cuspaceflight/white-giant-sensing-pcb/README.md

# WG-sensing-pcb
PCB Design for WGData Acquisition via Current Loop Sensors

Current Design in KiCAD for 2x12 Sensors.

## Next Steps
- Create a separate Buck Converter board for a clean 5.4V DC supply
- Rework PCB Layout to only integrate some 5 sensors and test different designs
