cuspaceflight/white-giant-sensing-pcb/daq_griffin/daq_griffin.kicad_pcb

## KiCad design daq_griffin/daq_griffin.kicad_pcb (2025-04-25)

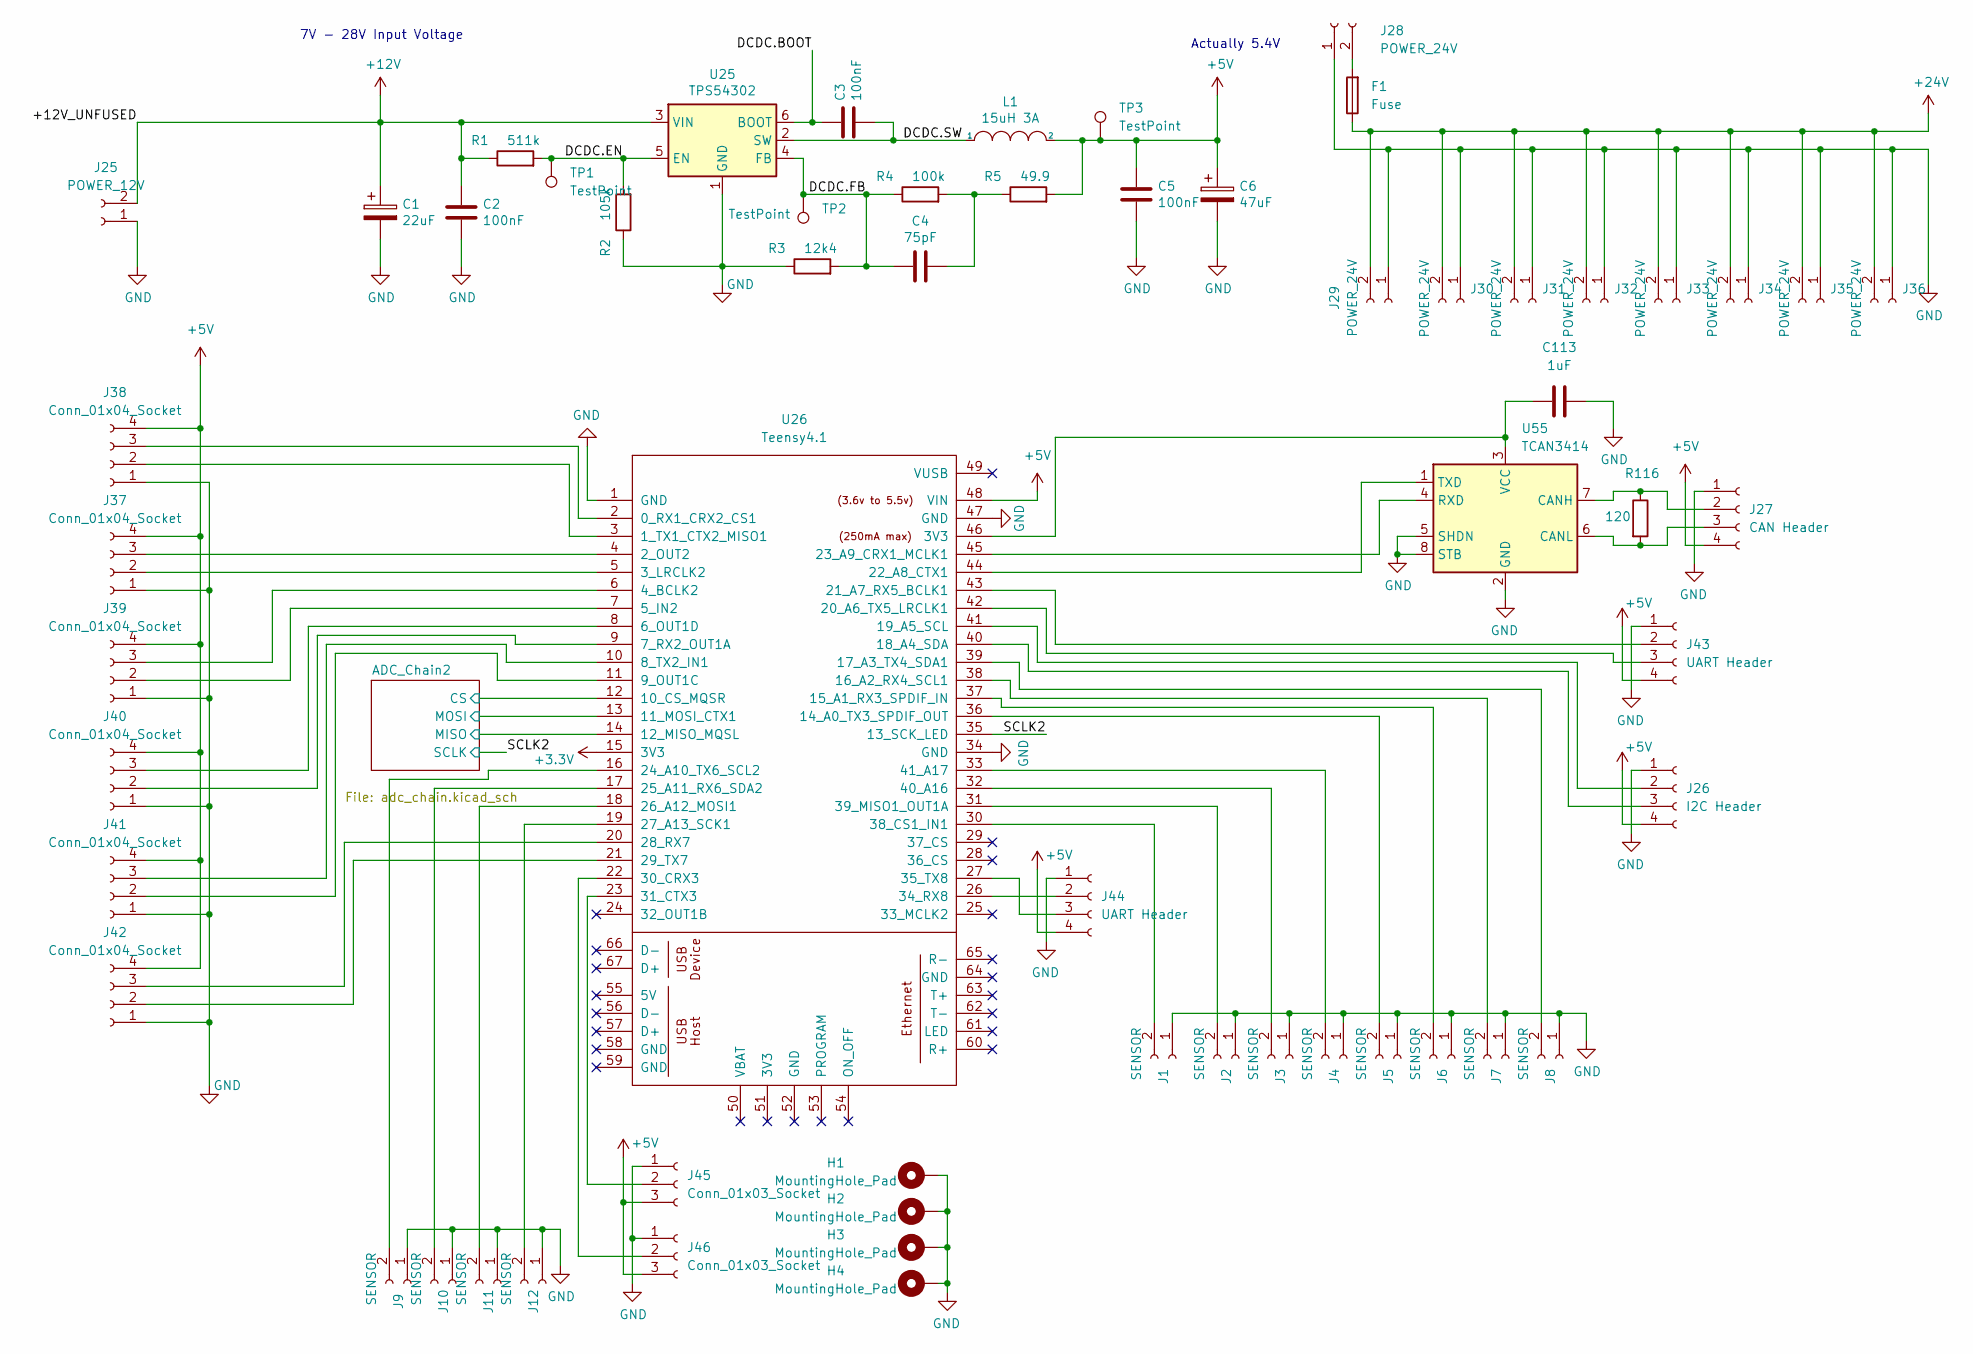
[picture p1: schematic daq_griffin.kicad_sch]

Parts:
C1: 22uF; C_0805_2012Metric_Pad1.18x1.45mm_HandSolder; Rating 25V; MPN generic C%f %v %r; LCSC C5674
C2, C3, C5: 100nF; C_0603_1608Metric_Pad1.08x0.95mm_HandSolder; MPN generic C%f %v %r; LCSC C1590
C4: 75pF; C_0603_1608Metric_Pad1.08x0.95mm_HandSolder; MPN generic C%f %v %r; LCSC C1681
C6: 47uF; C_0805_2012Metric_Pad1.18x1.45mm_HandSolder; Rating 6.3V; MPN generic C%f %v %r; LCSC C16780
C113: 1uF; C_0603_1608Metric_Pad1.08x0.95mm_HandSolder; LCSC C1592
F1: Fuse; Fuseholder_Cylinder-5x20mm_Stelvio-Kontek_PTF78_Horizontal_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
H1, H2, H3, H4: MountingHole_Pad; MountingHole_3.2mm_M3_Pad_Via
J1, J2, J3, J4, J5, J6, J7, J8, J9, J10, J11, J12: SENSOR; Molex_Nano-Fit_105309-xx02_1x02_P2.50mm_Vertical
J25: POWER_12V; Molex_Nano-Fit_105309-xx02_1x02_P2.50mm_Vertical
J26: I2C Header; Molex_Nano-Fit_105309-xx04_1x04_P2.50mm_Vertical
J27: CAN Header; Molex_Nano-Fit_105309-xx04_1x04_P2.50mm_Vertical
J28, J29, J30, J31, J32, J33, J34, J35, J36: POWER_24V; Molex_Nano-Fit_105309-xx02_1x02_P2.50mm_Vertical
J37, J38, J39, J40, J41, J42: Conn_01x04_Socket; JST_XH_B4B-XH-A_1x04_P2.50mm_Vertical
J43, J44: UART Header; Molex_Nano-Fit_105309-xx04_1x04_P2.50mm_Vertical
J45, J46: Conn_01x03_Socket; Molex_Nano-Fit_105309-xx03_1x03_P2.50mm_Vertical
L1: 15uH 3A; L_Bourns_SRN6045TA; MPN Bourns SRN8040TA-150M; LCSC C1330797
R1: 511k; R_0603_1608Metric_Pad0.98x0.95mm_HandSolder; MPN generic R%f %v %r; LCSC C188257
R2: 105k; R_0603_1608Metric_Pad0.98x0.95mm_HandSolder; MPN generic R%f %v %r; LCSC C16840
R3: 12k4; R_0603_1608Metric_Pad0.98x0.95mm_HandSolder; MPN generic R%f %v %r; LCSC C22865
R4: 100k; R_0603_1608Metric_Pad0.98x0.95mm_HandSolder; MPN generic R%f %v %r; LCSC C14675
R5: 49.9; R_0603_1608Metric_Pad0.98x0.95mm_HandSolder; MPN generic R%f %v %r; LCSC C23185
R116: 120; R_0603_1608Metric_Pad0.98x0.95mm_HandSolder; LCSC C22787
TP1, TP2, TP3: TestPoint; TestPoint_Pad_D1.0mm
U25: TPS54302; SOT-23-6; MPN TI TPS54302DDC; LCSC C129370
U26: Teensy4.1; Teensy41
U55: TCAN3414; SOIC-8_3.9x4.9mm_P1.27mm; LCSC C30111221

Connections:
+3.3V: U26.15 (3V3); also elsewhere on the board
+5V: C5.1, C6.1, J26.4, J27.4, J37.4, J38.4, J39.4, J40.4, J41.4, J42.4, J43.4, J44.4, J45.3, J46.3, L1.2, R5.2, TP3.1, U26.48 (VIN); also elsewhere on the board
+12V: C1.1, C2.1, J25.2, R1.1, U25.3 (VIN); also elsewhere on the board
+24V: F1.1, J29.2, J30.2, J31.2, J32.2, J33.2, J34.2, J35.2, J36.2
/ADC_Chain2/CS: U26.12 (10_CS_MQSR); also elsewhere on the board
/ADC_Chain2/MISO: U26.14 (12_MISO_MQSL); also elsewhere on the board
/ADC_Chain2/MOSI: U26.13 (11_MOSI_CTX1); also elsewhere on the board
/DCDC.BOOT: C3.1, U25.6 (BOOT)
/DCDC.EN: R1.2, R2.2, TP1.1, U25.5 (EN)
/DCDC.FB: C4.2, R3.2, R4.1, TP2.1, U25.4 (FB)
/DCDC.SW: C3.2, L1.1, U25.2 (SW)
/SCLK2: U26.35 (13_SCK_LED); also elsewhere on the board
GND: C1.2, C2.2, C5.2, C6.2, C113.2, H1.1, H2.1, H3.1, H4.1, J1.1, J2.1, J3.1, J4.1, J5.1, J6.1, J7.1, J8.1, J9.1, J10.1, J11.1, J12.1, J25.1, J26.1, J27.1, J28.1, J29.1, J30.1, J31.1, J32.1, J33.1, J34.1, J35.1, J36.1, J37.1, J38.1, J39.1, J40.1, J41.1, J42.1, J43.1, J44.1, J45.1, J46.1, R2.1, R3.1, U25.1 (GND), U26.1 (GND), U26.34 (GND), U26.47 (GND), U55.2 (GND), U55.5 (SHDN), U55.8 (STB); also elsewhere on the board
unnamed: C4.1, R4.2, R5.1
unnamed: J1.2, U26.30 (38_CS1_IN1)
unnamed: J2.2, U26.31 (39_MISO1_OUT1A)
unnamed: J3.2, U26.32 (40_A16)
unnamed: J4.2, U26.33 (41_A17)
unnamed: J5.2, U26.36 (14_A0_TX3_SPDIF_OUT)
unnamed: J6.2, U26.37 (15_A1_RX3_SPDIF_IN)
unnamed: J7.2, U26.38 (16_A2_RX4_SCL1)
unnamed: J8.2, U26.39 (17_A3_TX4_SDA1)
unnamed: J9.2, U26.16 (24_A10_TX6_SCL2)
unnamed: J10.2, U26.17 (25_A11_RX6_SDA2)
unnamed: J11.2, U26.18 (26_A12_MOSI1)
unnamed: J12.2, U26.19 (27_A13_SCK1)
unnamed: J26.2, U26.41 (19_A5_SCL)
unnamed: J26.3, U26.40 (18_A4_SDA)
unnamed: J27.2, R116.1, U55.7 (CANH)
unnamed: J27.3, R116.2, U55.6 (CANL)
unnamed: F1.2, J28.2
unnamed: J37.2, U26.5 (3_LRCLK2)
unnamed: J37.3, U26.4 (2_OUT2)
unnamed: J38.2, U26.3 (1_TX1_CTX2_MISO1)
unnamed: J38.3, U26.2 (0_RX1_CRX2_CS1)
unnamed: J39.2, U26.7 (5_IN2)
unnamed: J39.3, U26.6 (4_BCLK2)
unnamed: J40.2, U26.9 (7_RX2_OUT1A)
unnamed: J40.3, U26.8 (6_OUT1D)
unnamed: J41.2, U26.11 (9_OUT1C)
unnamed: J41.3, U26.10 (8_TX2_IN1)
unnamed: J42.2, U26.21 (29_TX7)
unnamed: J42.3, U26.20 (28_RX7)
unnamed: J43.2, U26.43 (21_A7_RX5_BCLK1)
unnamed: J43.3, U26.42 (20_A6_TX5_LRCLK1)
unnamed: J44.2, U26.26 (34_RX8)
unnamed: J44.3, U26.27 (35_TX8)
unnamed: J45.2, U26.23 (31_CTX3)
unnamed: J46.2, U26.22 (30_CRX3)
unnamed: U26.44 (22_A8_CTX1), U55.1 (TXD)
unnamed: U26.45 (23_A9_CRX1_MCLK1), U55.4 (RXD)
unnamed: C113.1, U26.46 (3V3), U55.3 (VCC)

Notes on the sheet:
Actually 5.4V
7V - 28V Input Voltage

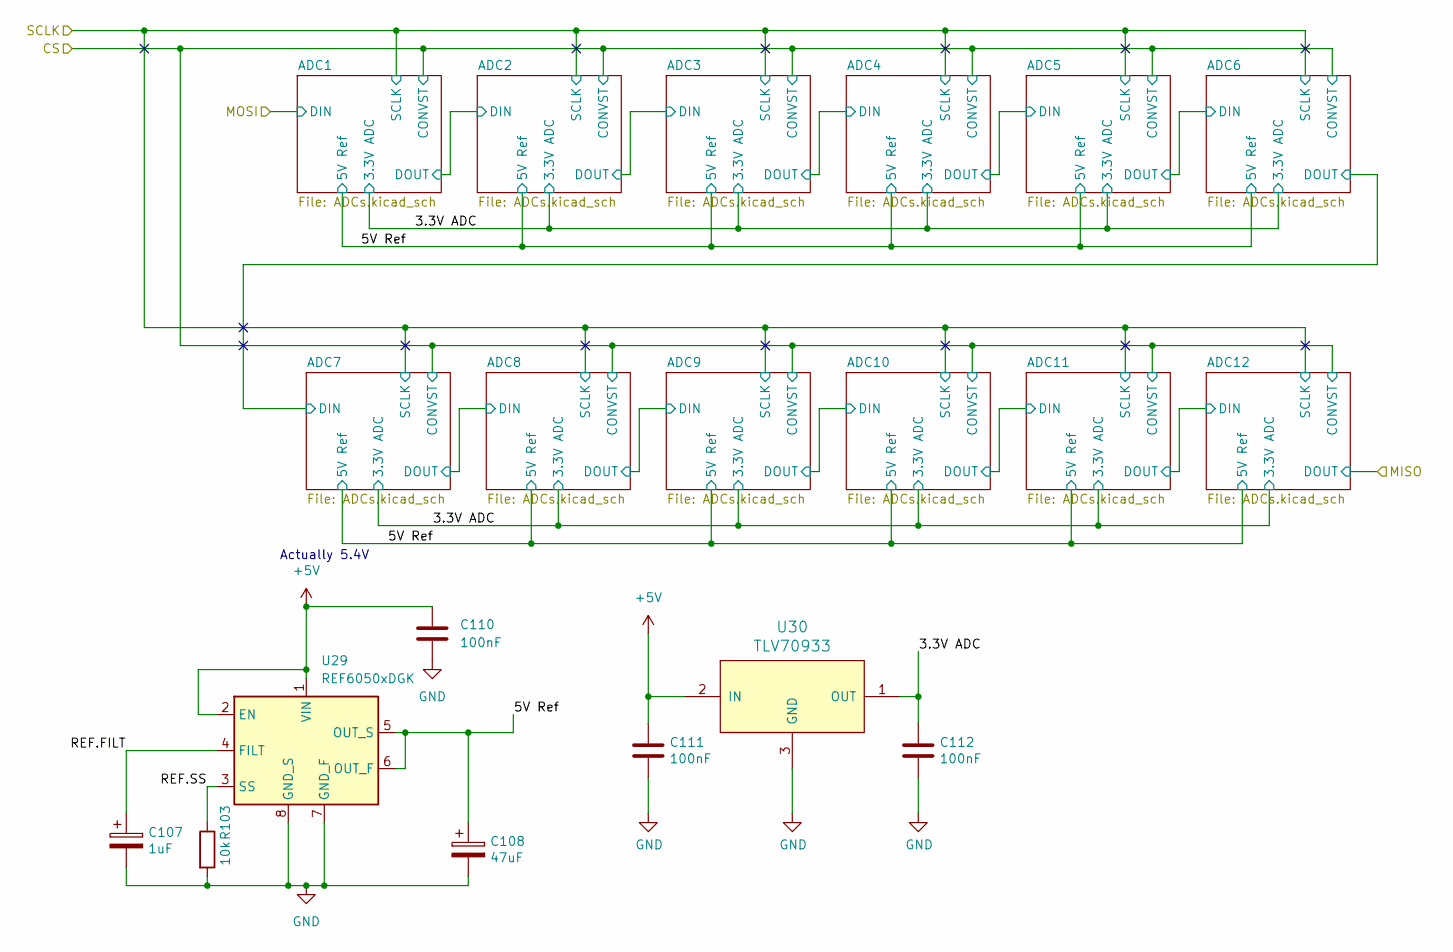
[picture p2: schematic adc_chain.kicad_sch]

Parts:
C107: 1uF; C_0603_1608Metric_Pad1.08x0.95mm_HandSolder; Rating 25V; MPN generic C%f %v %r; LCSC C1592
C108: 47uF; C_0805_2012Metric_Pad1.18x1.45mm_HandSolder; Rating 6.3V; MPN generic C%f %v %r; LCSC C16780
C110: 100nF; C_0603_1608Metric_Pad1.08x0.95mm_HandSolder; LCSC C1590
C111, C112: 100nF; C_0603_1608Metric_Pad1.08x0.95mm_HandSolder; MPN generic C%f %v %r; LCSC C1590
R103: 10k; R_0603_1608Metric_Pad0.98x0.95mm_HandSolder; MPN generic R%f %v %r; LCSC C15401
U29: REF6050xDGK; VSSOP-8_3.0x3.0mm_P0.65mm; LCSC C2157003
U30: TLV70933; SOT-23; MPN TI TLV76033DBZ; LCSC C133791

Connections:
+5V: C110.2, C111.1, U29.1 (VIN), U29.2 (EN), U30.2 (IN); also elsewhere on the board
/ADC_Chain2/3.3V ADC: C112.1, U30.1 (OUT); also elsewhere on the board
/ADC_Chain2/5V Ref: C108.1, U29.5 (OUT_S), U29.6 (OUT_F); also elsewhere on the board
/ADC_Chain2/REF.FILT: C107.1, U29.4 (FILT)
/ADC_Chain2/REF.SS: R103.1, U29.3 (SS)
GND: C107.2, C108.2, C110.1, C111.2, C112.2, R103.2, U29.7 (GND_F), U29.8 (GND_S), U30.3 (GND); also elsewhere on the board

Notes on the sheet:
Actually 5.4V

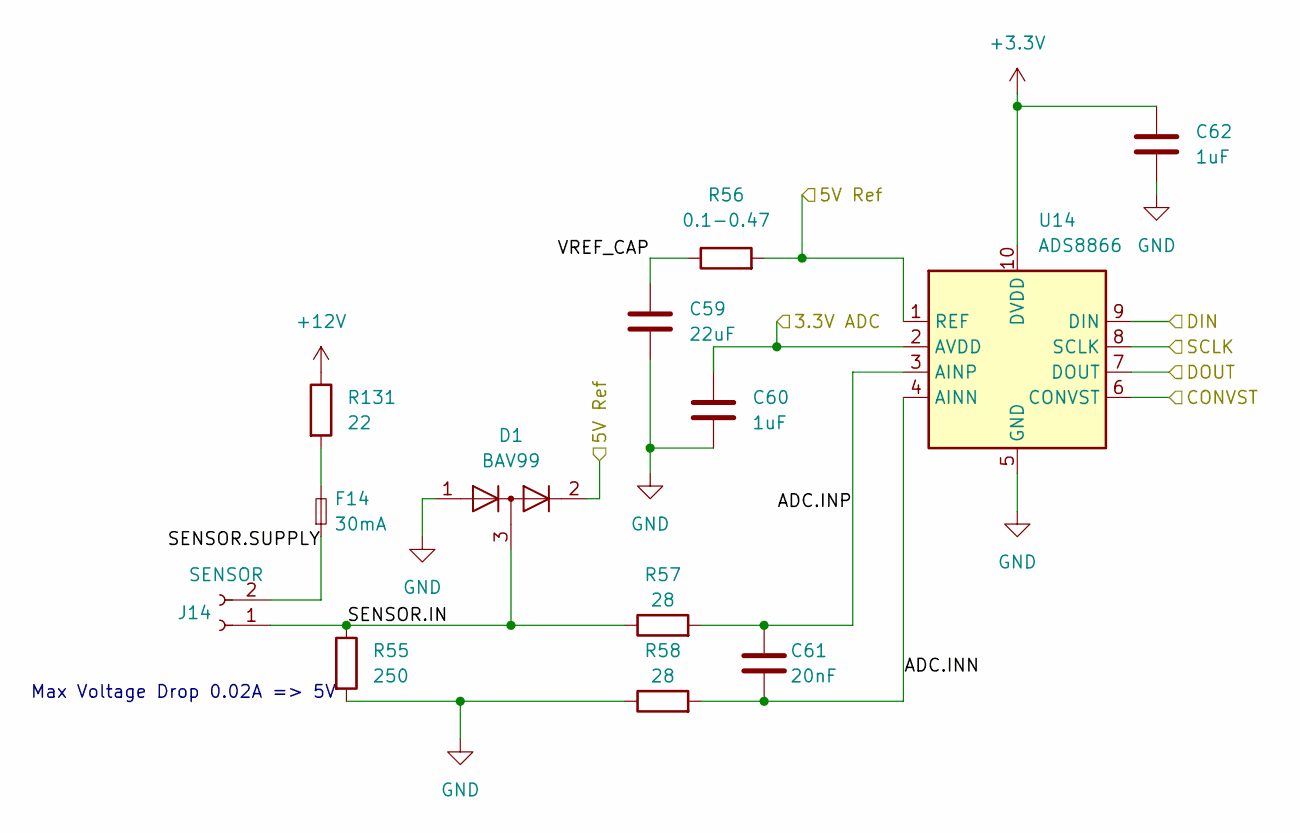
[picture p3: schematic ADCs.kicad_sch]

Parts:
C59: 22uF; C_0805_2012Metric_Pad1.18x1.45mm_HandSolder; LCSC C5674
C60, C62: 1uF; C_0603_1608Metric_Pad1.08x0.95mm_HandSolder; LCSC C1592
C61: 20nF; C_0603_1608Metric_Pad1.08x0.95mm_HandSolder; LCSC C307483
D1: BAV99; SOT-323_SC-70
F14: 30mA; Fuse_0603_1608Metric_Pad1.05x0.95mm_HandSolder; LCSC C914090
J14: SENSOR; Molex_Nano-Fit_105309-xx02_1x02_P2.50mm_Vertical
R55: 250; R_1206_3216Metric_Pad1.30x1.75mm_HandSolder; LCSC C2828898
R56: 0.1-0.47; R_0603_1608Metric_Pad0.98x0.95mm_HandSolder; LCSC C175686
R57, R58: 28; R_0603_1608Metric_Pad0.98x0.95mm_HandSolder; LCSC C217932
R131: 22; R_0603_1608Metric_Pad0.98x0.95mm_HandSolder; LCSC C1203
U14: ADS8866; VSSOP-10_3x3mm_P0.5mm; LCSC C455432

Connections:
+3.3V: C62.1, U14.10 (DVDD); also elsewhere on the board
+12V: R131.1; also elsewhere on the board
/ADC_Chain2/3.3V ADC: C60.1, U14.2 (AVDD); also elsewhere on the board
/ADC_Chain2/5V Ref: D1.2 (A), R56.2, U14.1 (REF); also elsewhere on the board
/ADC_Chain2/ADC1/DOUT: U14.9 (DIN); also elsewhere on the board
/ADC_Chain2/ADC2/ADC.INN: C61.2, R58.2, U14.4 (AINN)
/ADC_Chain2/ADC2/ADC.INP: C61.1, R57.2, U14.3 (AINP)
/ADC_Chain2/ADC2/DOUT: U14.7 (DOUT); also elsewhere on the board
/ADC_Chain2/ADC2/SENSOR.IN: D1.3 (K), J14.1, R55.1, R57.1
/ADC_Chain2/ADC2/SENSOR.SUPPLY: F14.1, J14.2
/ADC_Chain2/ADC2/VREF_CAP: C59.1, R56.1
/ADC_Chain2/CS: U14.6 (CONVST); also elsewhere on the board
/SCLK2: U14.8 (SCLK); also elsewhere on the board
GND: C59.2, C60.2, C62.2, D1.1 (K), R55.2, R58.1, U14.5 (GND); also elsewhere on the board
unnamed: F14.2, R131.2

Parts of its further copies:
C63, C67, C71, C75, C79, C83, C87, C91, C95, C99, C103: 22uF; C_0805_2012Metric_Pad1.18x1.45mm_HandSolder; LCSC C5674
C64, C66, C68, C70, C72, C74, C76, C78, C80, C82, C84, C86, C88, C90, C92, C94, C96, C98, C100, C102, C104, C106: 1uF; C_0603_1608Metric_Pad1.08x0.95mm_HandSolder; LCSC C1592
C65, C69, C73, C77, C81, C85, C89, C93, C97, C101, C105: 20nF; C_0603_1608Metric_Pad1.08x0.95mm_HandSolder; LCSC C307483
D2, D3, D4, D5, D6, D7, D8, D9, D10, D11, D12: BAV99; SOT-323_SC-70
F13, F15, F16, F17, F18, F19, F20, F21, F22, F23, F24: 30mA; Fuse_0603_1608Metric_Pad1.05x0.95mm_HandSolder; LCSC C914090
J13, J15, J16, J17, J18, J19, J20, J21, J22, J23, J24: SENSOR; Molex_Nano-Fit_105309-xx02_1x02_P2.50mm_Vertical
R59, R63, R67, R71, R75, R79, R83, R87, R91, R95, R99: 250; R_1206_3216Metric_Pad1.30x1.75mm_HandSolder; LCSC C2828898
R60, R64, R68, R72, R76, R80, R84, R88, R92, R96, R100: 0.1-0.47; R_0603_1608Metric_Pad0.98x0.95mm_HandSolder; LCSC C175686
R61, R62, R65, R66, R69, R70, R73, R74, R77, R78, R81, R82, R85, R86, R89, R90, R93, R94, R97, R98, R101, R102: 28; R_0603_1608Metric_Pad0.98x0.95mm_HandSolder; LCSC C217932
R130, R132, R133, R134, R135, R136, R137, R138, R139, R140, R141: 22; R_0603_1608Metric_Pad0.98x0.95mm_HandSolder; LCSC C1203
U13, U15, U16, U17, U18, U19, U20, U21, U22, U23, U24: ADS8866; VSSOP-10_3x3mm_P0.5mm; LCSC C455432

Connections of its further copies:
+3.3V: C66.1, C70.1, C74.1, C78.1, C82.1, C86.1, C90.1, C94.1, C98.1, C102.1, C106.1, U13.10 (DVDD), U15.10 (DVDD), U16.10 (DVDD), U17.10 (DVDD), U18.10 (DVDD), U19.10 (DVDD), U20.10 (DVDD), U21.10 (DVDD), U22.10 (DVDD), U23.10 (DVDD), U24.10 (DVDD); also elsewhere on the board
+12V: R130.1, R132.1, R133.1, R134.1, R135.1, R136.1, R137.1, R138.1, R139.1, R140.1, R141.1; also elsewhere on the board
/ADC_Chain2/3.3V ADC: C64.1, C68.1, C72.1, C76.1, C80.1, C84.1, C88.1, C92.1, C96.1, C100.1, C104.1, U13.2 (AVDD), U15.2 (AVDD), U16.2 (AVDD), U17.2 (AVDD), U18.2 (AVDD), U19.2 (AVDD), U20.2 (AVDD), U21.2 (AVDD), U22.2 (AVDD), U23.2 (AVDD), U24.2 (AVDD); also elsewhere on the board
/ADC_Chain2/5V Ref: D2.2 (A), D3.2 (A), D4.2 (A), D5.2 (A), D6.2 (A), D7.2 (A), D8.2 (A), D9.2 (A), D10.2 (A), D11.2 (A), D12.2 (A), R60.2, R64.2, R68.2, R72.2, R76.2, R80.2, R84.2, R88.2, R92.2, R96.2, R100.2, U13.1 (REF), U15.1 (REF), U16.1 (REF), U17.1 (REF), U18.1 (REF), U19.1 (REF), U20.1 (REF), U21.1 (REF), U22.1 (REF), U23.1 (REF), U24.1 (REF); also elsewhere on the board
/ADC_Chain2/ADC1/ADC.INN: C69.2, R66.2, U13.4 (AINN)
/ADC_Chain2/ADC1/ADC.INP: C69.1, R65.2, U13.3 (AINP)
/ADC_Chain2/ADC1/DOUT: U13.7 (DOUT); also elsewhere on the board
/ADC_Chain2/ADC1/SENSOR.IN: D3.3 (K), J13.1, R63.1, R65.1
/ADC_Chain2/ADC1/SENSOR.SUPPLY: F13.1, J13.2
/ADC_Chain2/ADC1/VREF_CAP: C67.1, R64.1
/ADC_Chain2/ADC2/DOUT: U15.9 (DIN); also elsewhere on the board
/ADC_Chain2/ADC3/ADC.INN: C65.2, R62.2, U15.4 (AINN)
/ADC_Chain2/ADC3/ADC.INP: C65.1, R61.2, U15.3 (AINP)
/ADC_Chain2/ADC3/DOUT: U15.7 (DOUT), U16.9 (DIN)
/ADC_Chain2/ADC3/SENSOR.IN: D2.3 (K), J15.1, R59.1, R61.1
/ADC_Chain2/ADC3/SENSOR.SUPPLY: F15.1, J15.2
/ADC_Chain2/ADC3/VREF_CAP: C63.1, R60.1
/ADC_Chain2/ADC4/ADC.INN: C101.2, R98.2, U16.4 (AINN)
/ADC_Chain2/ADC4/ADC.INP: C101.1, R97.2, U16.3 (AINP)
/ADC_Chain2/ADC4/DOUT: U16.7 (DOUT), U17.9 (DIN)
/ADC_Chain2/ADC4/SENSOR.IN: D11.3 (K), J16.1, R95.1, R97.1
/ADC_Chain2/ADC4/SENSOR.SUPPLY: F16.1, J16.2
/ADC_Chain2/ADC4/VREF_CAP: C99.1, R96.1
/ADC_Chain2/ADC5/ADC.INN: C73.2, R70.2, U17.4 (AINN)
/ADC_Chain2/ADC5/ADC.INP: C73.1, R69.2, U17.3 (AINP)
/ADC_Chain2/ADC5/DOUT: U17.7 (DOUT), U18.9 (DIN)
/ADC_Chain2/ADC5/SENSOR.IN: D4.3 (K), J17.1, R67.1, R69.1
/ADC_Chain2/ADC5/SENSOR.SUPPLY: F17.1, J17.2
/ADC_Chain2/ADC5/VREF_CAP: C71.1, R68.1
/ADC_Chain2/ADC6/ADC.INN: C77.2, R74.2, U18.4 (AINN)
/ADC_Chain2/ADC6/ADC.INP: C77.1, R73.2, U18.3 (AINP)
/ADC_Chain2/ADC6/DOUT: U18.7 (DOUT), U19.9 (DIN)
/ADC_Chain2/ADC6/SENSOR.IN: D5.3 (K), J18.1, R71.1, R73.1
/ADC_Chain2/ADC6/SENSOR.SUPPLY: F18.1, J18.2
/ADC_Chain2/ADC6/VREF_CAP: C75.1, R72.1
/ADC_Chain2/ADC7/ADC.INN: C81.2, R78.2, U19.4 (AINN)
/ADC_Chain2/ADC7/ADC.INP: C81.1, R77.2, U19.3 (AINP)
/ADC_Chain2/ADC7/DOUT: U19.7 (DOUT), U20.9 (DIN)
/ADC_Chain2/ADC7/SENSOR.IN: D6.3 (K), J19.1, R75.1, R77.1
/ADC_Chain2/ADC7/SENSOR.SUPPLY: F19.1, J19.2
/ADC_Chain2/ADC7/VREF_CAP: C79.1, R76.1
/ADC_Chain2/ADC8/ADC.INN: C85.2, R82.2, U20.4 (AINN)
/ADC_Chain2/ADC8/ADC.INP: C85.1, R81.2, U20.3 (AINP)
/ADC_Chain2/ADC8/DOUT: U20.7 (DOUT), U21.9 (DIN)
/ADC_Chain2/ADC8/SENSOR.IN: D7.3 (K), J20.1, R79.1, R81.1
/ADC_Chain2/ADC8/SENSOR.SUPPLY: F20.1, J20.2
/ADC_Chain2/ADC8/VREF_CAP: C83.1, R80.1
/ADC_Chain2/ADC9/ADC.INN: C89.2, R86.2, U21.4 (AINN)
/ADC_Chain2/ADC9/ADC.INP: C89.1, R85.2, U21.3 (AINP)
/ADC_Chain2/ADC9/SENSOR.IN: D8.3 (K), J21.1, R83.1, R85.1
/ADC_Chain2/ADC9/SENSOR.SUPPLY: F21.1, J21.2
/ADC_Chain2/ADC9/VREF_CAP: C87.1, R84.1
/ADC_Chain2/ADC10/ADC.INN: C93.2, R90.2, U22.4 (AINN)
/ADC_Chain2/ADC10/ADC.INP: C93.1, R89.2, U22.3 (AINP)
/ADC_Chain2/ADC10/DIN: U21.7 (DOUT), U22.9 (DIN)
/ADC_Chain2/ADC10/DOUT: U22.7 (DOUT), U23.9 (DIN)
/ADC_Chain2/ADC10/SENSOR.IN: D9.3 (K), J22.1, R87.1, R89.1
/ADC_Chain2/ADC10/SENSOR.SUPPLY: F22.1, J22.2
/ADC_Chain2/ADC10/VREF_CAP: C91.1, R88.1
/ADC_Chain2/ADC11/ADC.INN: C97.2, R94.2, U23.4 (AINN)
/ADC_Chain2/ADC11/ADC.INP: C97.1, R93.2, U23.3 (AINP)
/ADC_Chain2/ADC11/DOUT: U23.7 (DOUT), U24.9 (DIN)
/ADC_Chain2/ADC11/SENSOR.IN: D10.3 (K), J23.1, R91.1, R93.1
/ADC_Chain2/ADC11/SENSOR.SUPPLY: F23.1, J23.2
/ADC_Chain2/ADC11/VREF_CAP: C95.1, R92.1
/ADC_Chain2/ADC12/ADC.INN: C105.2, R102.2, U24.4 (AINN)
/ADC_Chain2/ADC12/ADC.INP: C105.1, R101.2, U24.3 (AINP)
/ADC_Chain2/ADC12/SENSOR.IN: D12.3 (K), J24.1, R99.1, R101.1
/ADC_Chain2/ADC12/SENSOR.SUPPLY: F24.1, J24.2
/ADC_Chain2/ADC12/VREF_CAP: C103.1, R100.1
/ADC_Chain2/CS: U13.6 (CONVST), U15.6 (CONVST), U16.6 (CONVST), U17.6 (CONVST), U18.6 (CONVST), U19.6 (CONVST), U20.6 (CONVST), U21.6 (CONVST), U22.6 (CONVST), U23.6 (CONVST), U24.6 (CONVST); also elsewhere on the board
/ADC_Chain2/MISO: U24.7 (DOUT); also elsewhere on the board
/ADC_Chain2/MOSI: U13.9 (DIN); also elsewhere on the board
/SCLK2: U13.8 (SCLK), U15.8 (SCLK), U16.8 (SCLK), U17.8 (SCLK), U18.8 (SCLK), U19.8 (SCLK), U20.8 (SCLK), U21.8 (SCLK), U22.8 (SCLK), U23.8 (SCLK), U24.8 (SCLK); also elsewhere on the board
GND: C63.2, C64.2, C66.2, C67.2, C68.2, C70.2, C71.2, C72.2, C74.2, C75.2, C76.2, C78.2, C79.2, C80.2, C82.2, C83.2, C84.2, C86.2, C87.2, C88.2, C90.2, C91.2, C92.2, C94.2, C95.2, C96.2, C98.2, C99.2, C100.2, C102.2, C103.2, C104.2, C106.2, D2.1 (K), D3.1 (K), D4.1 (K), D5.1 (K), D6.1 (K), D7.1 (K), D8.1 (K), D9.1 (K), D10.1 (K), D11.1 (K), D12.1 (K), R59.2, R62.1, R63.2, R66.1, R67.2, R70.1, R71.2, R74.1, R75.2, R78.1, R79.2, R82.1, R83.2, R86.1, R87.2, R90.1, R91.2, R94.1, R95.2, R98.1, R99.2, R102.1, U13.5 (GND), U15.5 (GND), U16.5 (GND), U17.5 (GND), U18.5 (GND), U19.5 (GND), U20.5 (GND), U21.5 (GND), U22.5 (GND), U23.5 (GND), U24.5 (GND); also elsewhere on the board
unnamed: F13.2, R130.2
unnamed: F15.2, R132.2
unnamed: F16.2, R133.2
unnamed: F17.2, R134.2
unnamed: F18.2, R135.2
unnamed: F19.2, R136.2
unnamed: F20.2, R137.2
unnamed: F21.2, R138.2
unnamed: F22.2, R139.2
unnamed: F23.2, R140.2
unnamed: F24.2, R141.2

Notes on the sheet:
Max Voltage Drop 0.02A => 5V

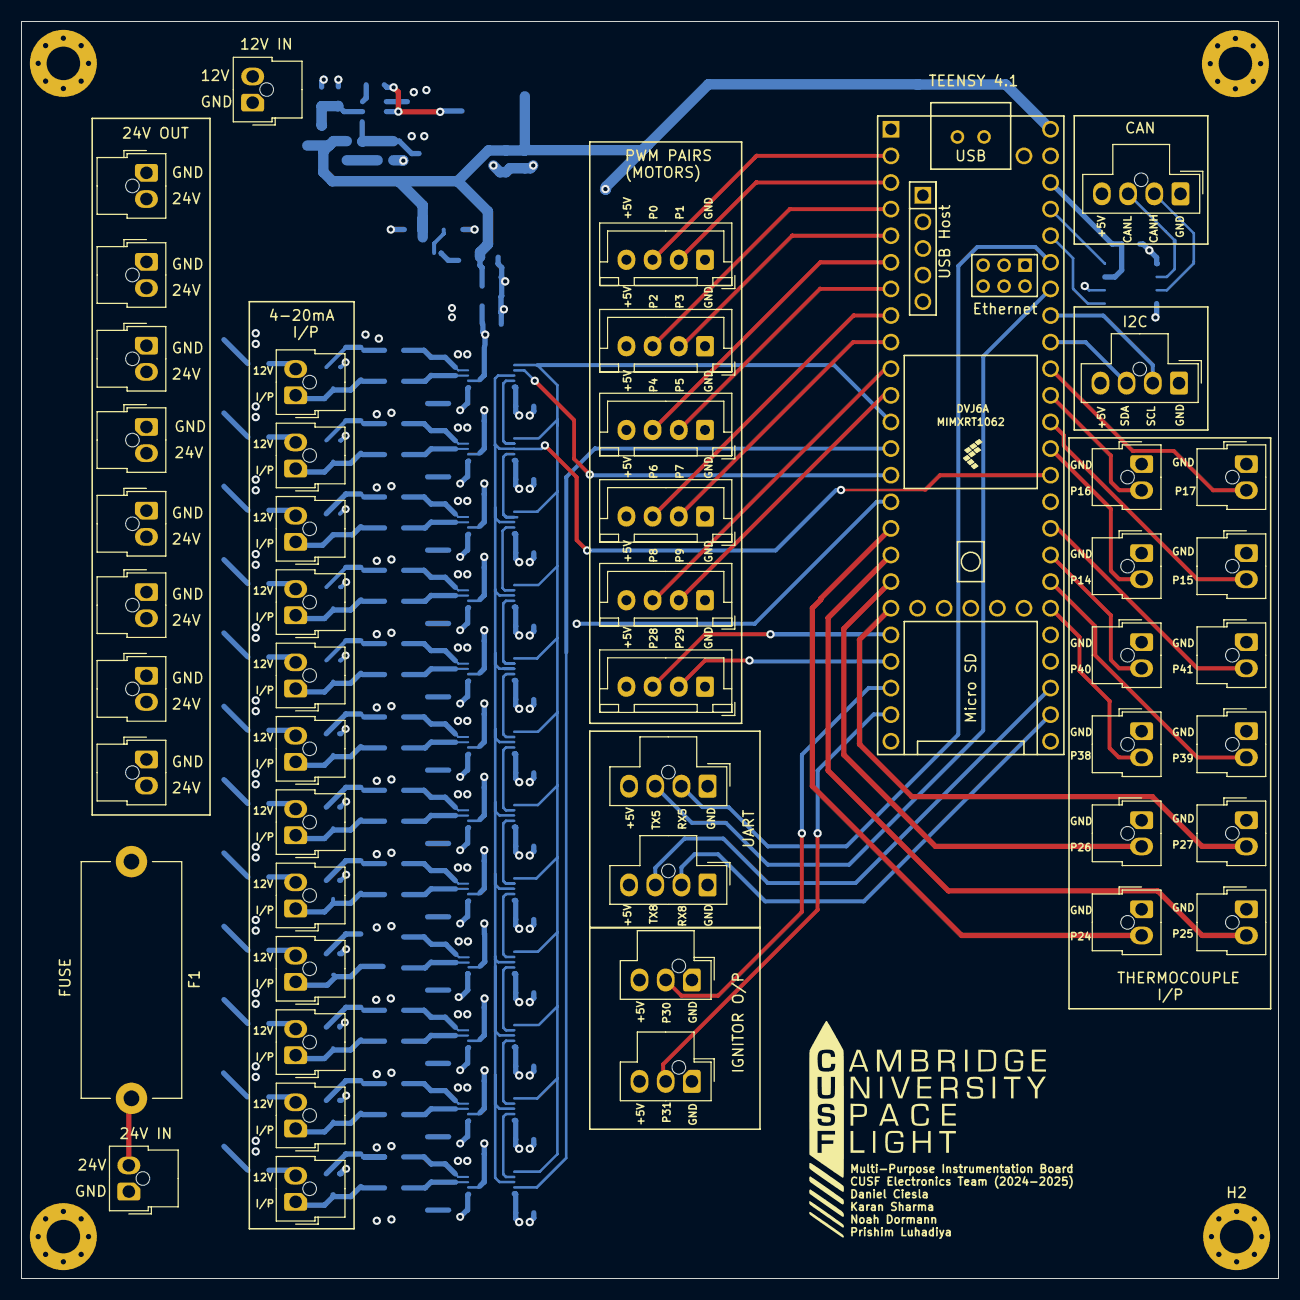
[picture p4: board daq_griffin.kicad_pcb from above]

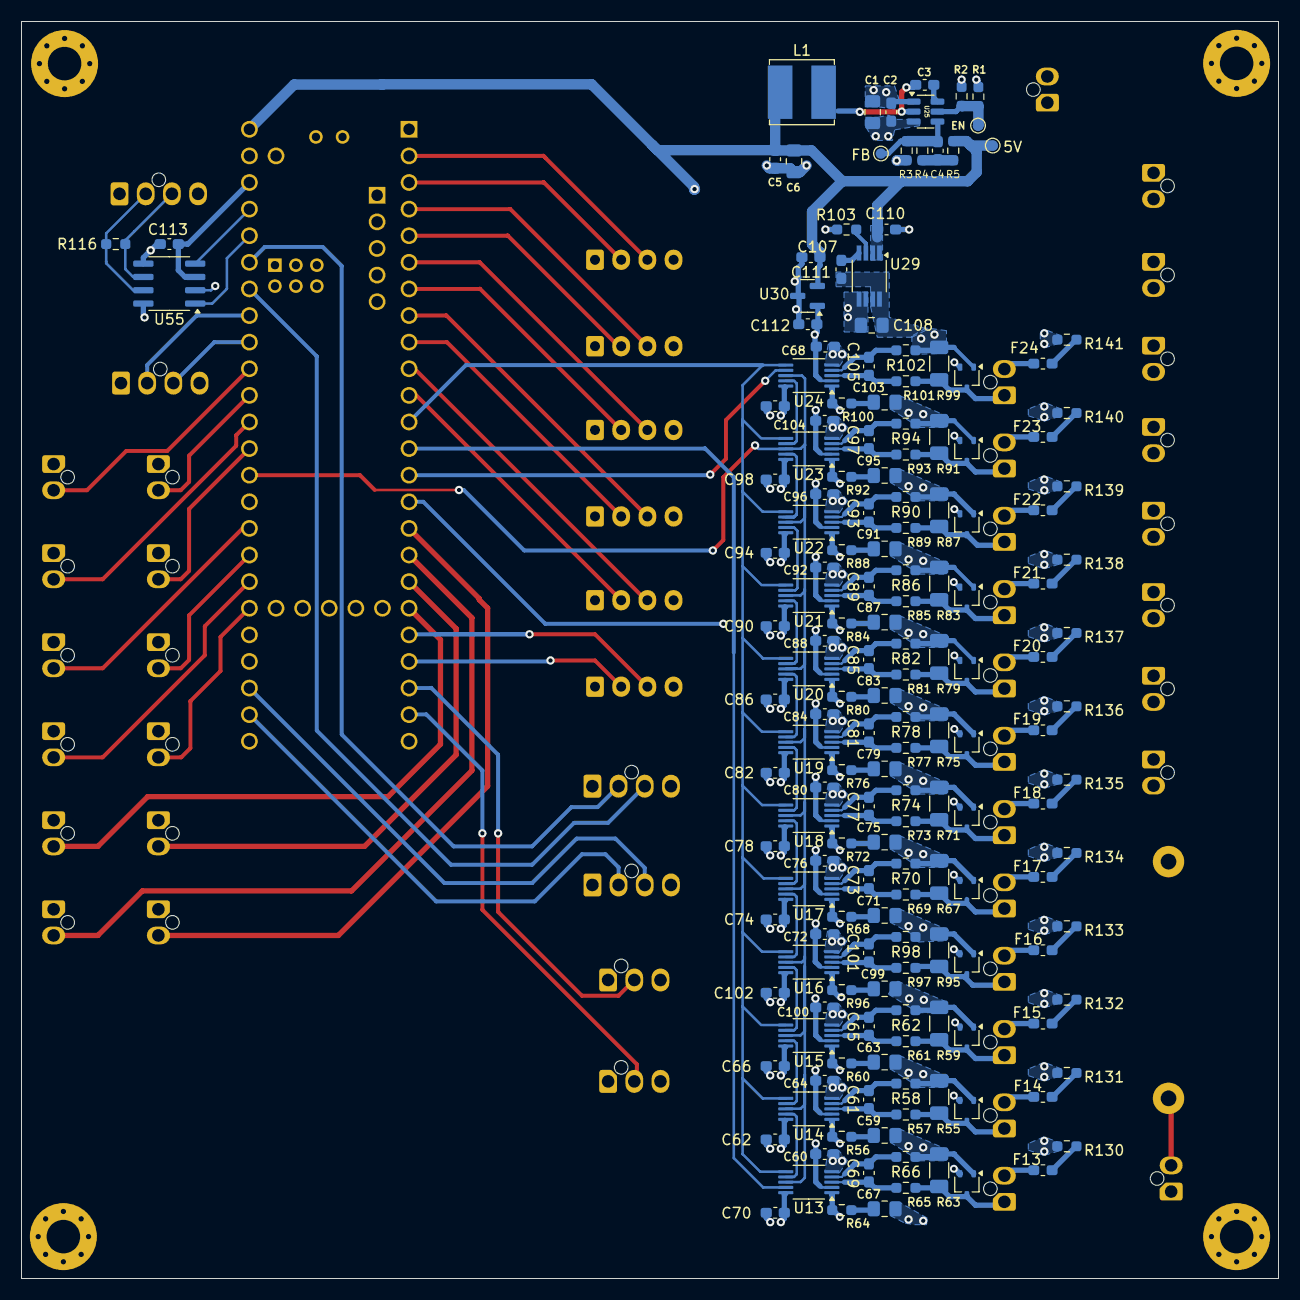
[picture p5: board daq_griffin.kicad_pcb from below]

Board: 4 copper layers, 120.0 x 120.0 mm, 223 parts (171 on the bottom side), 139 nets.
