cuspaceflight/white-giant-sensing-pcb/(commit log)

2024-11-22 Add files via upload
    one 5 V plane contained only 2 connections, so it was replaced with a single wire
    [daq_griffin.kicad_pcb]
2024-12-07 Add thermocouple connectors and minor layout changes.
    [ADCs.kicad_sch, daq_griffin.kicad_pcb, daq_griffin.kicad_sch]
2024-12-08 Change CUSF logo to F Silkscreen from User layer
    [daq_griffin.kicad_pcb]
2025-02-09 Add 24V capability, add feed systems motor connections, fix SPI connections, add ignitor board connections, add i2c connections.
    [daq_griffin.kicad_pcb, daq_griffin.kicad_sch]
2025-02-11 Rewired right side and fixed dual transistor
    [ADCs.kicad_sch, daq_griffin.kicad_pcb, daq_griffin.kicad_sch]
2025-02-23 Complete Silkscreen
    [ADCs.kicad_sch, daq_griffin.kicad_pcb, daq_griffin.kicad_sch]
2025-03-02 Final touches to silkscreen and hole clearance, names added
    [daq_griffin.kicad_pcb, daq_griffin.kicad_sch]
2025-03-23 Move 12V - 5V converter circuit to back of board.
    [daq_griffin.kicad_pcb]
2025-04-24 Inductor footprint changed, ADC fuse value now 30mA, ADC 25R resistor now 22R, 0.1-0.47R resistor set to 0.47R
    [ADCs.kicad_sch, adc_chain.kicad_sch, daq_griffin.kicad_pcb, daq_griffin.kicad_sch]
2025-04-25 Added JLCPCB part numbers to all back side components to be in PCBA
    [ADCs.kicad_sch, adc_chain.kicad_sch, daq_griffin.kicad_pcb, daq_griffin.kicad_sch]
